lorenzgeisser/Pen-Plotter/CAD/Pulley.SLDASM

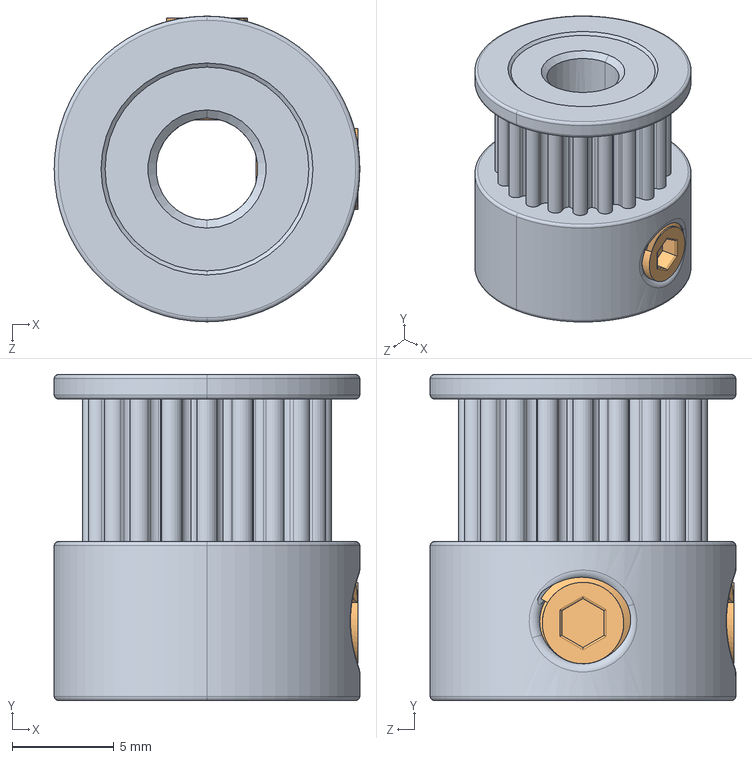
[picture p1: CAD file, 2022-06-19]
CAD/Pulley.SLDASM
15.0 x 16.0 x 15.0 mm
Pulley.STEP
Pulley Screw.STEP x 2
