lorenzgeisser/Pen-Plotter/CAD/Belt Clamp.SLDPRT

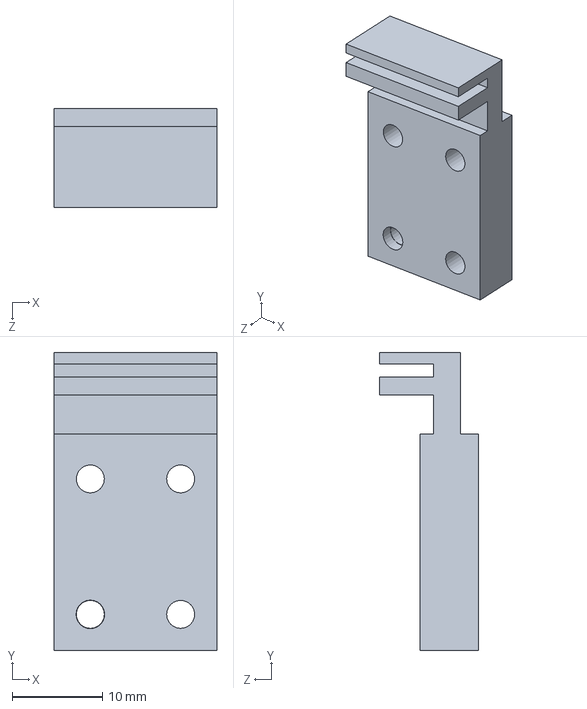
[picture p2: CAD file, 2022-06-23]
CAD/Belt Clamp.SLDPRT
18.0 x 33.0 x 11.0 mm
