lorenzgeisser/Pen-Plotter/PCB/KicadFiles/3d/OLED TFT 0.96 inch 64x128 monochrome.STEP

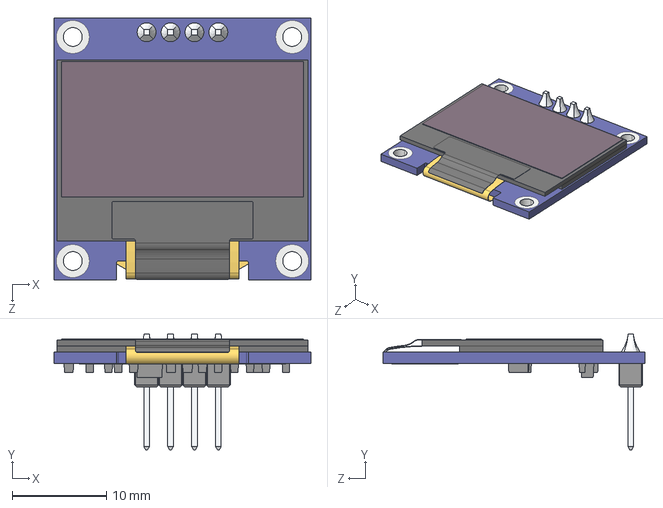
[picture p3: CAD file, 2022-07-03]
PCB/KicadFiles/3d/OLED TFT 0.96 inch 64x128 monochrome.STEP
27.3 x 12.3 x 27.8 mm
