lorenzgeisser/Pen-Plotter/CAD/Middle.SLDPRT

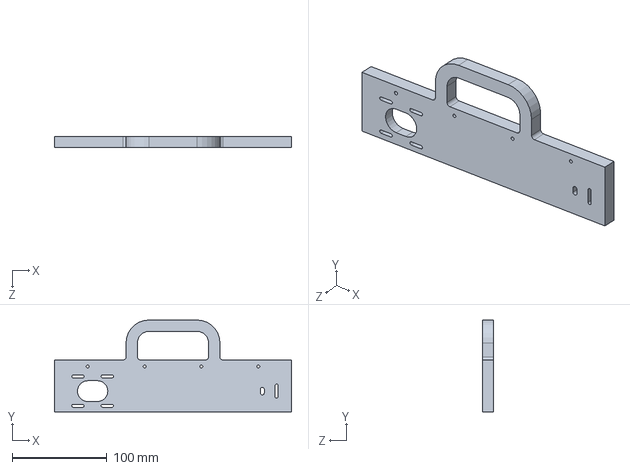
[picture p4: CAD file, 2022-06-20]
CAD/Middle.SLDPRT
250.0 x 97.0 x 12.0 mm
