lorenzgeisser/Pen-Plotter/PCB/KicadFiles/3d/BarrelJackSMD v3.step

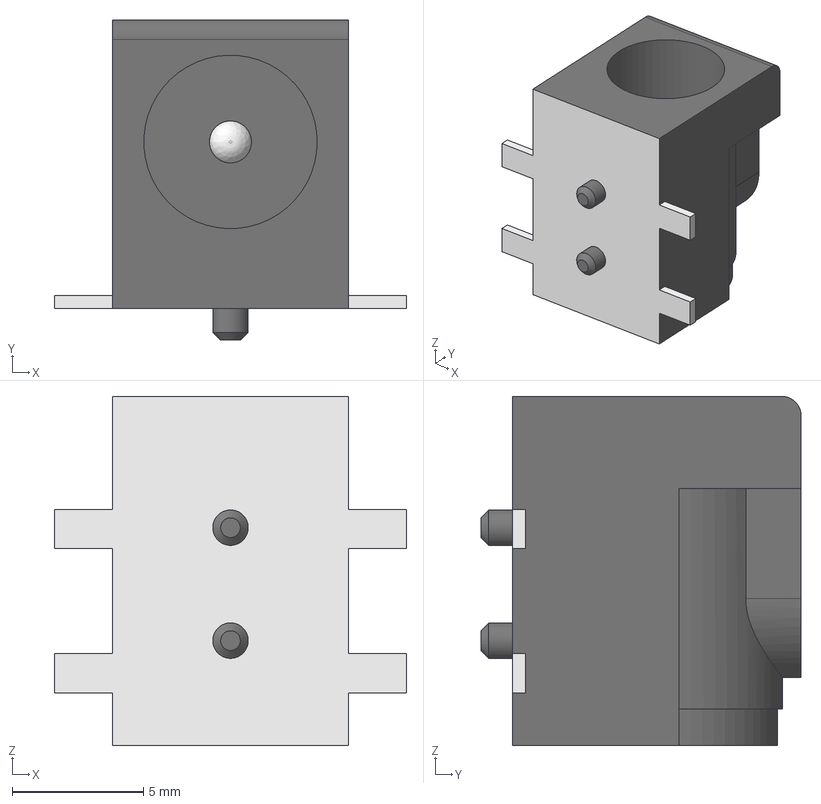
[picture p5: CAD file, 2022-07-03]
PCB/KicadFiles/3d/BarrelJackSMD v3.step
13.4 x 12.2 x 13.3 mm
