lorenzgeisser/Pen-Plotter/CAD/Leg Right.SLDPRT

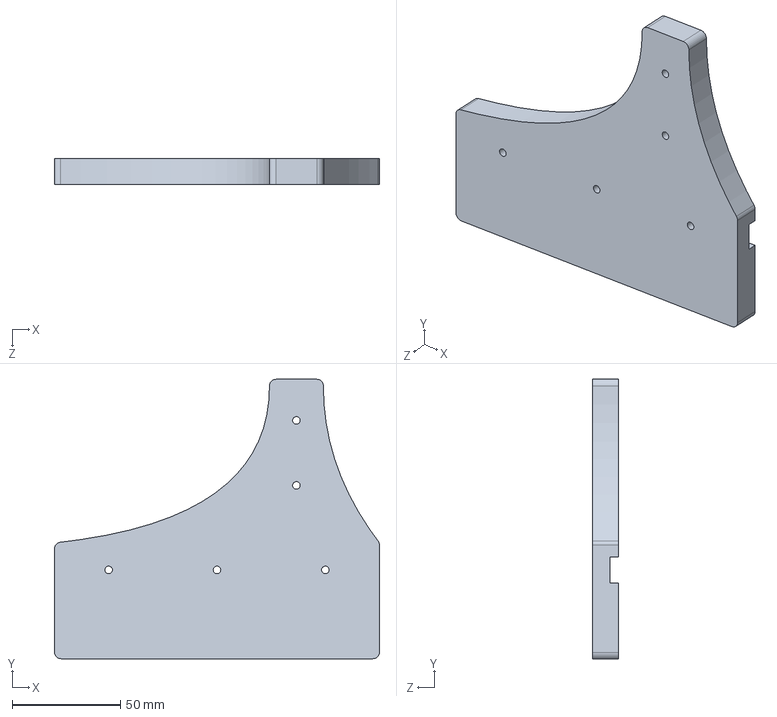
[picture p6: CAD file, 2022-06-20]
CAD/Leg Right.SLDPRT
150.0 x 129.0 x 12.0 mm
