lorenzgeisser/Pen-Plotter/PCB/KicadFiles/3d/TMC2209-V1.2 Bigtreetech.STEP

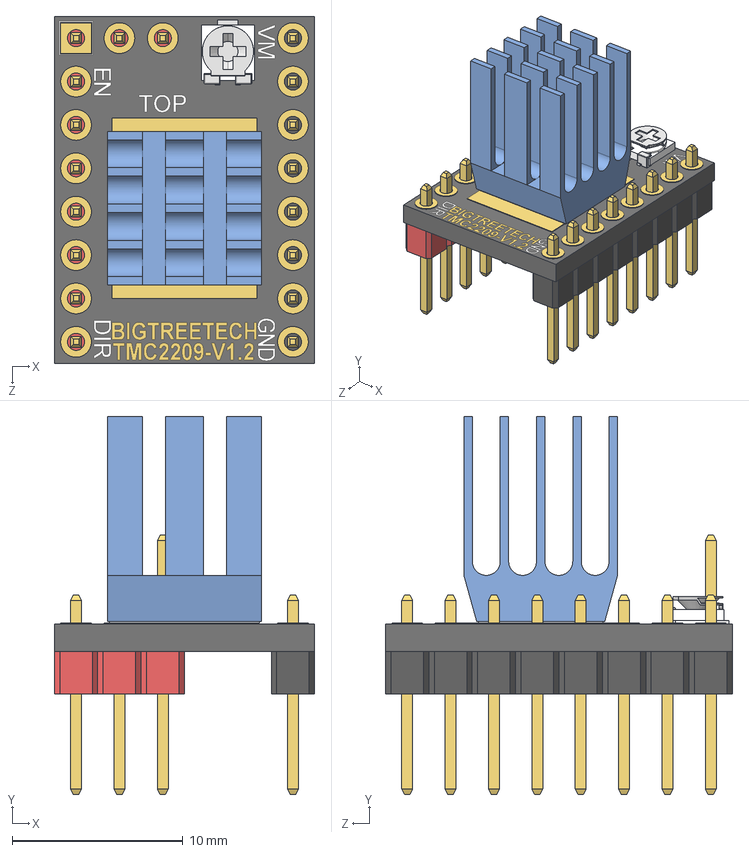
[picture p7: CAD file, 2022-06-23]
PCB/KicadFiles/3d/TMC2209-V1.2 Bigtreetech.STEP
15.2 x 22.1 x 20.3 mm
TMC2209_board
Pin_Header_1x2_red
Pin_Header_1x8_red
Pin_Header_1x8_black
EVM-3E___ _________
TMC2209_heatsink
