lorenzgeisser/Pen-Plotter/CAD/Schalter.SLDPRT

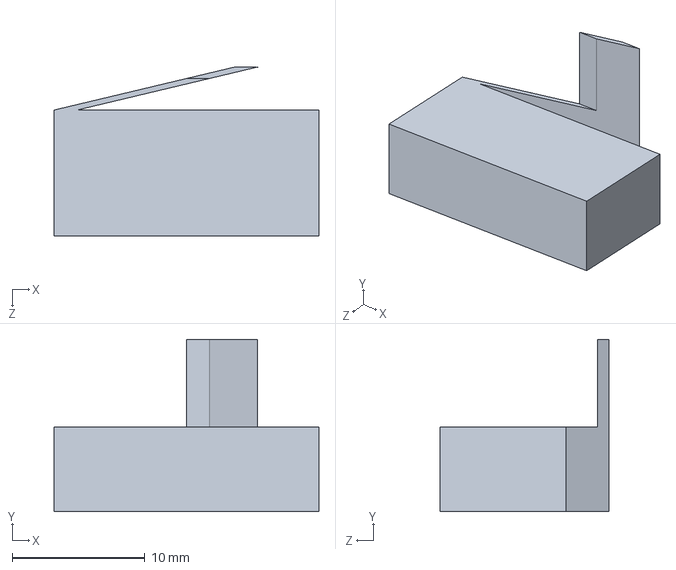
[picture p8: CAD file, 2022-06-20]
CAD/Schalter.SLDPRT
20.0 x 13.0 x 12.8 mm
