lorenzgeisser/Pen-Plotter/CAD/Penholder 1.SLDPRT

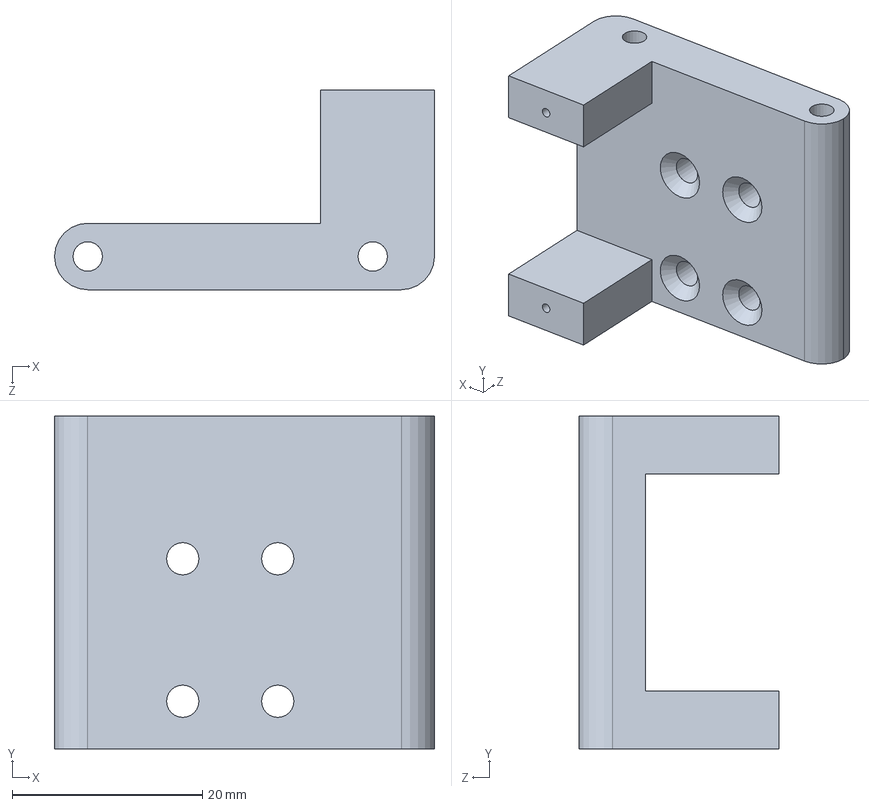
[picture p9: CAD file, 2022-06-19]
CAD/Penholder 1.SLDPRT
40.0 x 35.0 x 21.0 mm
