lorenzgeisser/Pen-Plotter/CAD/Pulley Holder.SLDPRT

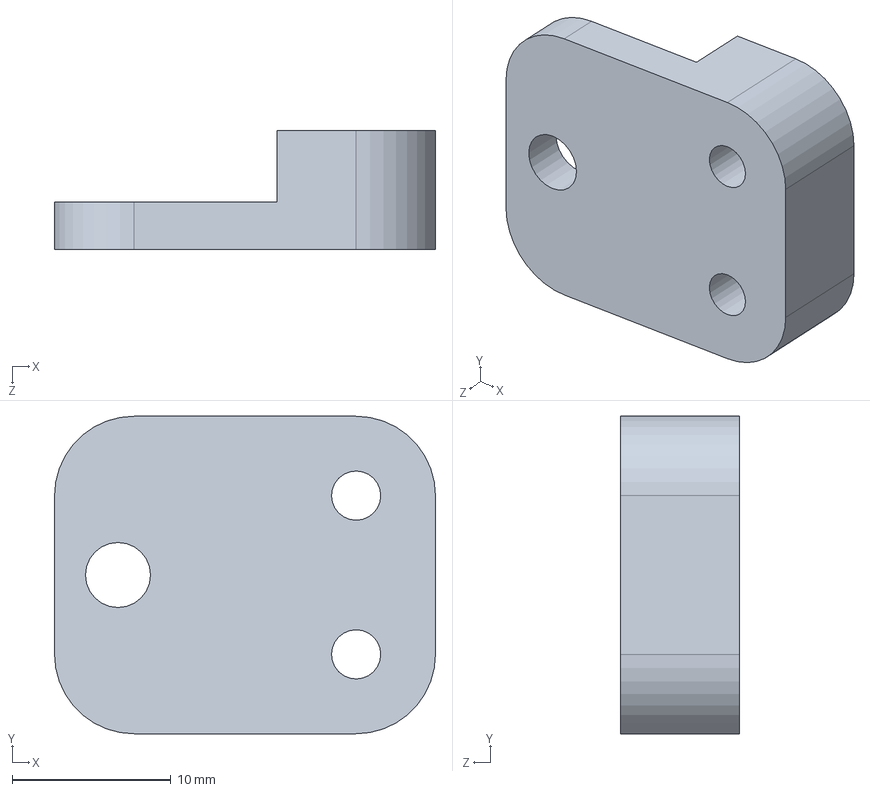
[picture p10: CAD file, 2022-06-19]
CAD/Pulley Holder.SLDPRT
24.0 x 20.0 x 7.50 mm
