lorenzgeisser/Pen-Plotter/CAD/Pin 3mm.SLDPRT

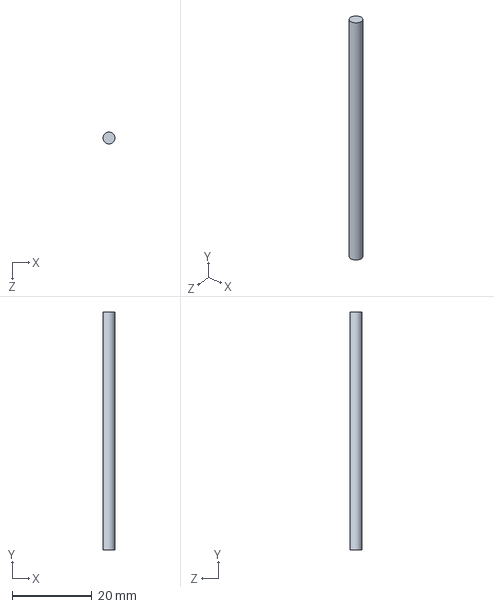
[picture p11: CAD file, 2022-06-19]
CAD/Pin 3mm.SLDPRT
3.00 x 59.7 x 3.00 mm
