lorenzgeisser/Pen-Plotter/CAD/Servo Horn.SLDPRT

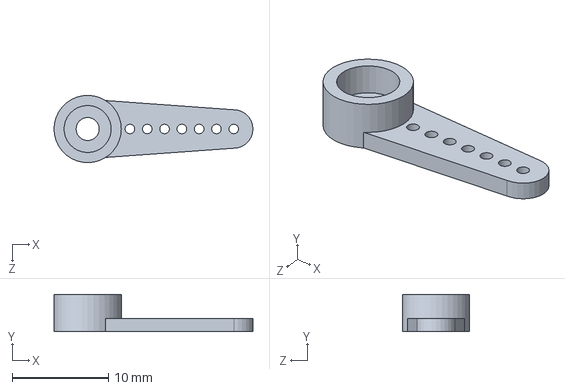
[picture p12: CAD file, 2022-06-19]
CAD/Servo Horn.SLDPRT
20.7 x 3.90 x 7.00 mm
