lorenzgeisser/Pen-Plotter/CAD/Servo.SLDPRT

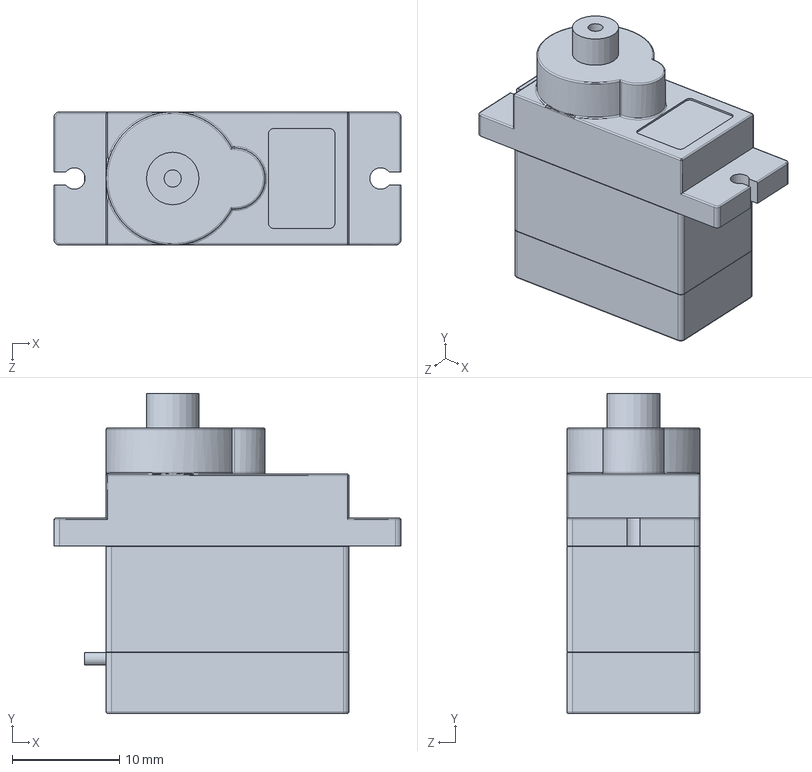
[picture p13: CAD file, 2022-06-19]
CAD/Servo.SLDPRT
32.3 x 29.8 x 12.4 mm
