lorenzgeisser/Pen-Plotter/CAD/Cart.SLDPRT

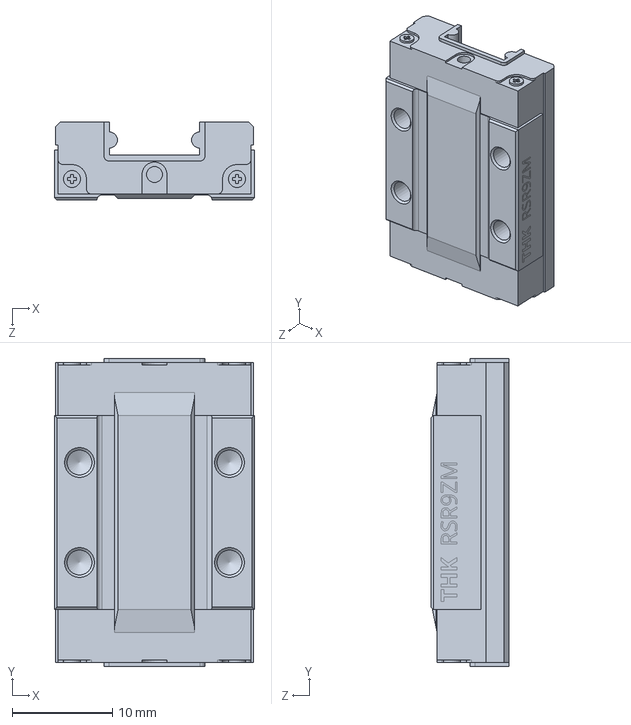
[picture p14: CAD file, 2022-06-19]
CAD/Cart.SLDPRT
20.0 x 30.8 x 7.80 mm
