lorenzgeisser/Pen-Plotter/CAD/Pen.SLDPRT

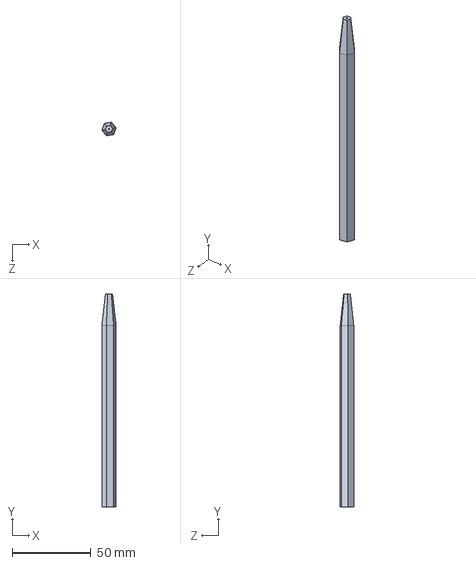
[picture p15: CAD file, 2022-06-19]
CAD/Pen.SLDPRT
9.12 x 135.0 x 8.63 mm
