lorenzgeisser/Pen-Plotter/CAD/Coaster.SLDPRT

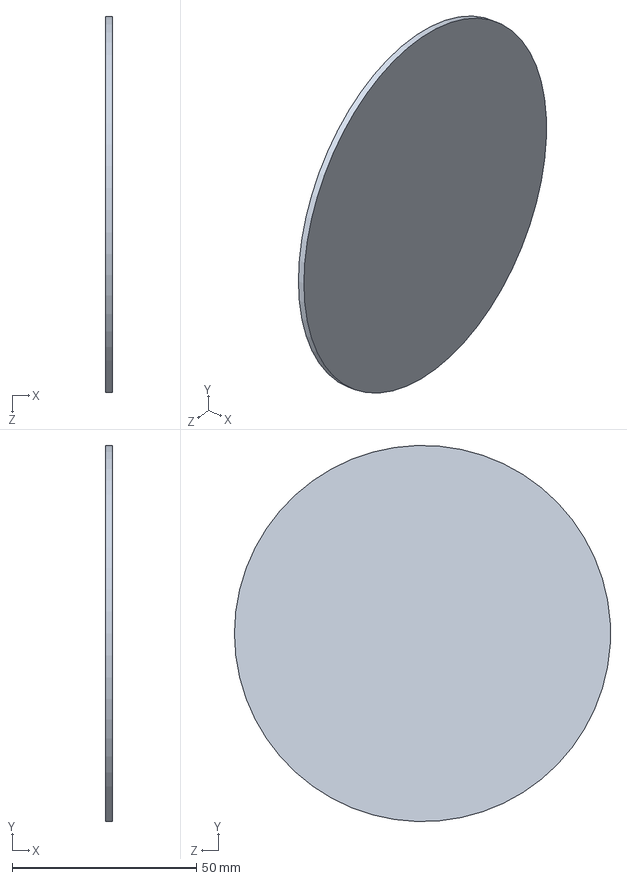
[picture p16: CAD file, 2022-06-19]
CAD/Coaster.SLDPRT
1.80 x 102.0 x 102.0 mm
