lorenzgeisser/Pen-Plotter/CAD/Baseplate.SLDPRT

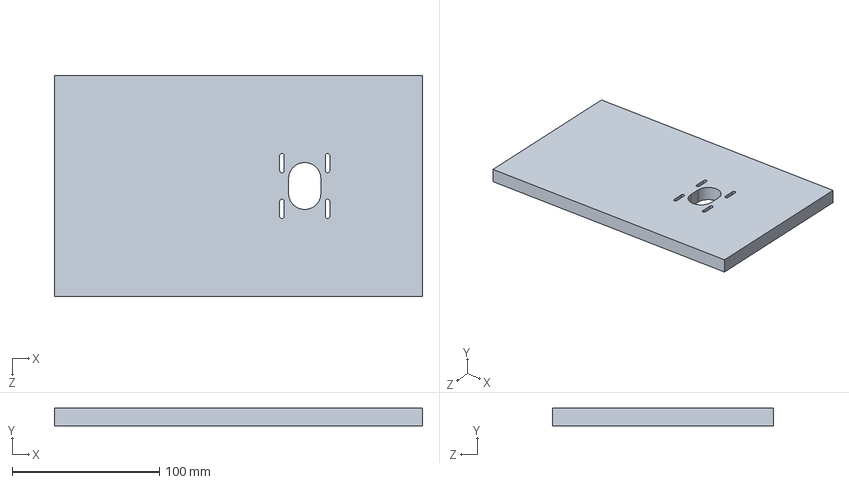
[picture p17: CAD file, 2022-06-19]
CAD/Baseplate.SLDPRT
250.0 x 12.0 x 150.0 mm
