lorenzgeisser/Pen-Plotter/CAD/Coaster Holder.SLDPRT

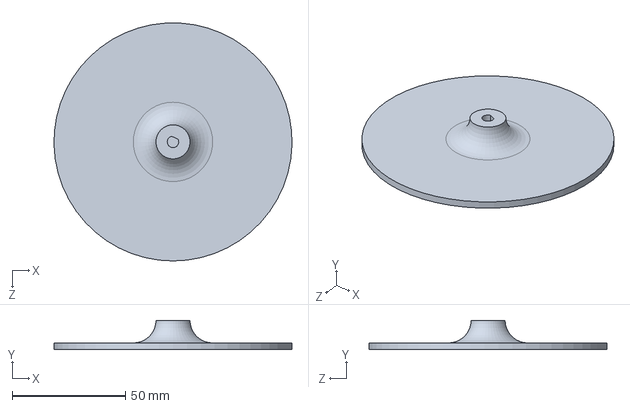
[picture p18: CAD file, 2022-06-19]
CAD/Coaster Holder.SLDPRT
105.0 x 13.0 x 104.9 mm
