lorenzgeisser/Pen-Plotter/CAD/Penholder 2.SLDPRT

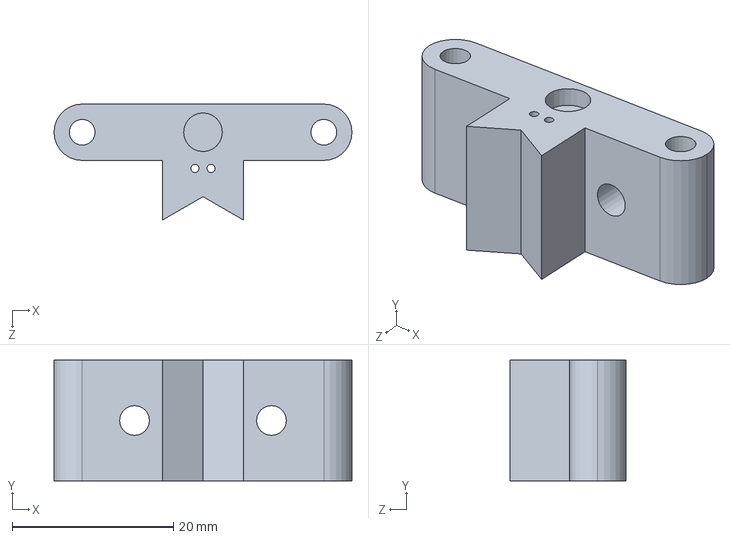
[picture p19: CAD file, 2022-06-19]
CAD/Penholder 2.SLDPRT
37.0 x 15.0 x 14.4 mm
