lorenzgeisser/Pen-Plotter/CAD/Motor.SLDPRT

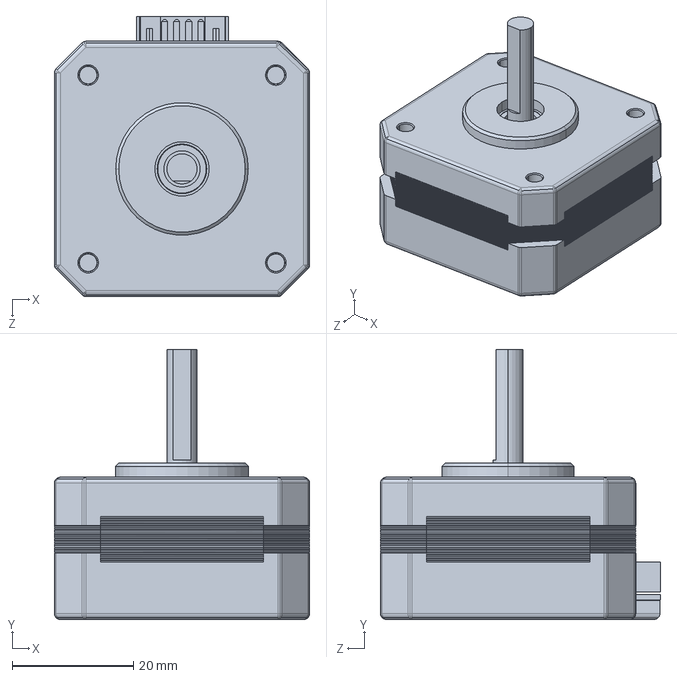
[picture p20: CAD file, 2022-06-19]
CAD/Motor.SLDPRT
42.2 x 44.6 x 46.3 mm
