lorenzgeisser/Pen-Plotter/CAD/Flat Pulley.SLDPRT

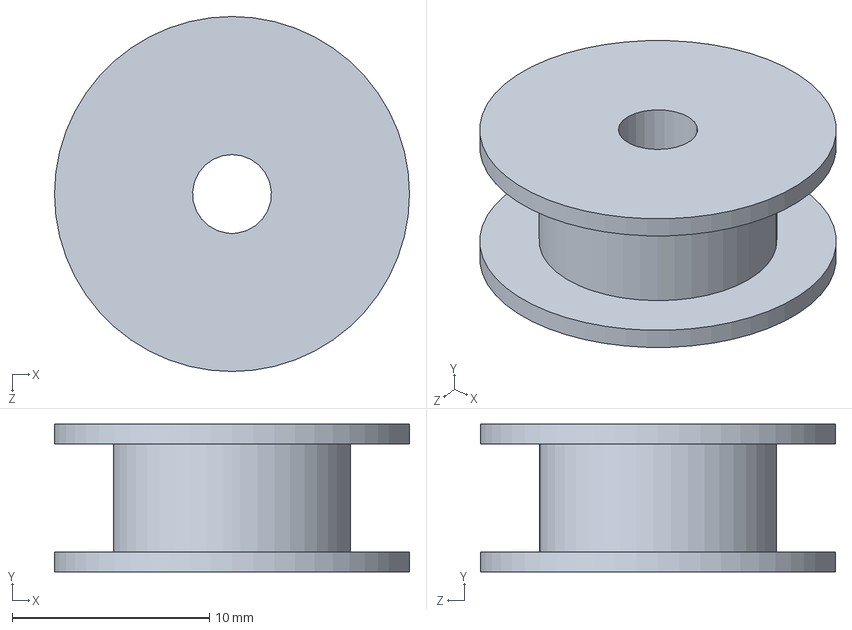
[picture p21: CAD file, 2022-06-19]
CAD/Flat Pulley.SLDPRT
18.0 x 7.50 x 18.0 mm
