lorenzgeisser/Pen-Plotter/CAD/Rail.SLDPRT

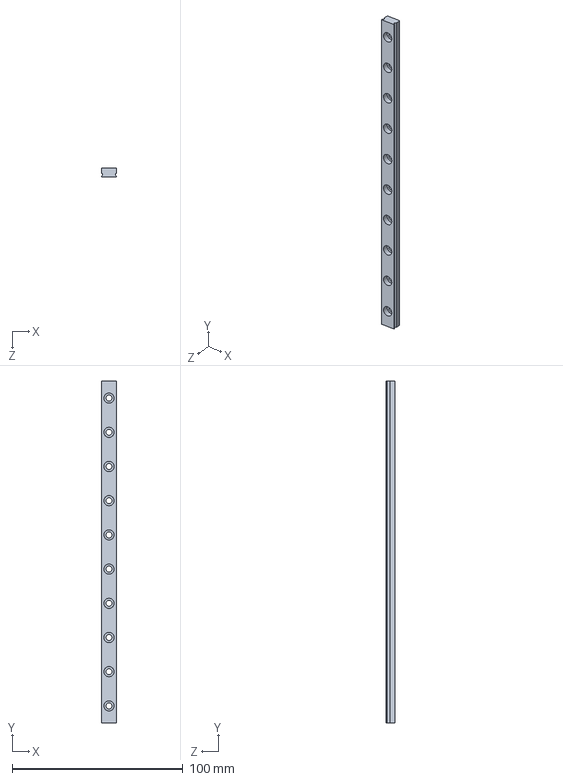
[picture p22: CAD file, 2022-06-19]
CAD/Rail.SLDPRT
9.00 x 200.0 x 5.50 mm
