lorenzgeisser/Pen-Plotter/(list of files, cad)

Other CAD files:
CAD/Leg Left.SLDPRT
CAD/Pulley.STEP.SLDPRT
CAD/Baseplate.DXF
CAD/Baseplate.SLDDRW
CAD/Leg Left.DXF
CAD/Leg Left.SLDDRW
CAD/Leg Right.DXF
CAD/Leg Right.SLDDRW
CAD/M3 Washer.SLDPRT
CAD/Middle.DXF
CAD/Middle.SLDDRW
CAD/Pulley Screw.STEP.SLDPRT
