lorenzgeisser/Pen-Plotter/PCB/KicadFiles/Plotter.kicad_pcb

## KiCad design PCB/KicadFiles/Plotter.kicad_pcb (2022-07-11)

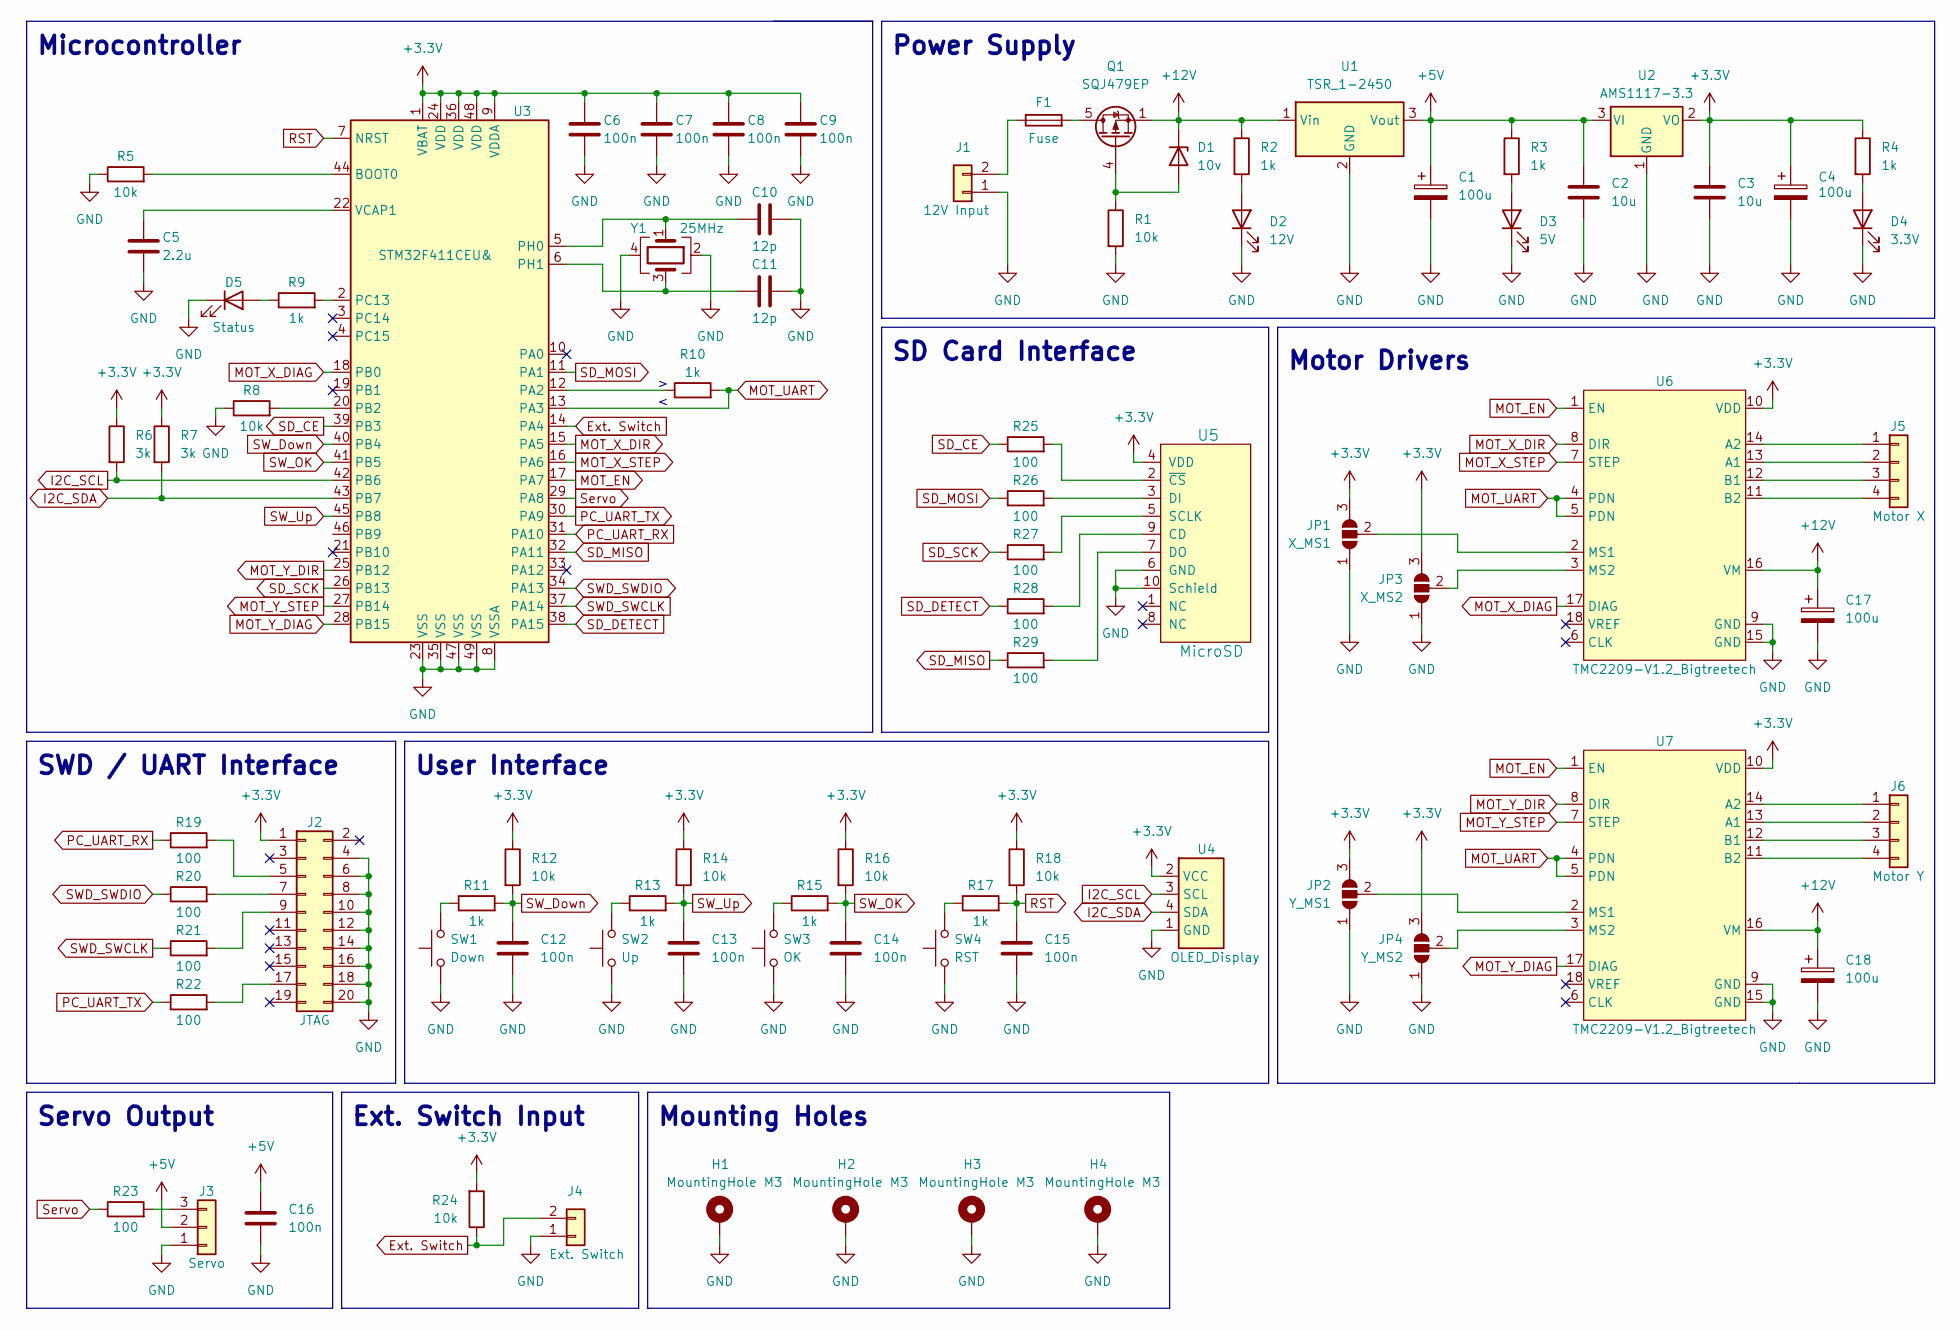
[picture p24: schematic Plotter.kicad_sch]

Parts:
C1, C4, C17, C18: 100u; CP_Elec_6.3x7.7
C2, C3: 10u; C_0805_2012Metric
C5: 2.2u; C_0402_1005Metric
C6, C7, C8, C9: 100n; C_0402_1005Metric
C10, C11: 12p; C_0402_1005Metric
C12, C13, C14, C15, C16: 100n; C_0805_2012Metric
D1: 10v; SOT-23
D2: 12V; LED_0805_2012Metric
D3: 5V; LED_0805_2012Metric
D4: 3.3V; LED_0805_2012Metric
D5: Status; LED_0805_2012Metric
F1: Fuse; Fuseholder_Cylinder-5x20mm_Schurter_0031_8201_Horizontal_Op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
H1, H2, H3, H4: MountingHole M3; MountingHole_3.2mm_M3_Pad_Via
J1: 12V Input; JST_XH_B2B-XH-A_1x02_P2.50mm_Vertical
J2: JTAG; IDC-Header_2x10_P2.54mm_Vertical
J3: Servo; JST_XH_B3B-XH-A_1x03_P2.50mm_Vertical
J4: Ext. Switch; JST_XH_B2B-XH-A_1x02_P2.50mm_Vertical
J5: Motor X; JST_XH_B4B-XH-A_1x04_P2.50mm_Vertical
J6: Motor Y; JST_XH_B4B-XH-A_1x04_P2.50mm_Vertical
JP1: X_MS1; SolderJumper-3_P1.3mm_Open_RoundedPad1.0x1.5mm
JP2: Y_MS1; SolderJumper-3_P1.3mm_Open_RoundedPad1.0x1.5mm
JP3: X_MS2; SolderJumper-3_P1.3mm_Open_RoundedPad1.0x1.5mm
JP4: Y_MS2; SolderJumper-3_P1.3mm_Open_RoundedPad1.0x1.5mm
Q1: SQJ479EP; TDSON-8-1
R1, R5, R8, R12, R14, R16, R18, R24: 10k; R_0805_2012Metric
R2, R3, R4, R9, R10, R11, R13, R15, R17: 1k; R_0805_2012Metric
R6, R7: 3k; R_0805_2012Metric
R19, R20, R21, R22, R23, R25, R26, R27, R28, R29: 100; R_0805_2012Metric
SW1: Down; SW_PUSH_6mm_H5mm
SW2: Up; SW_PUSH_6mm_H5mm
SW3: OK; SW_PUSH_6mm_H5mm
SW4: RST; SW_PUSH_6mm_H5mm
U1: TSR_1-2450; Converter_DCDC_TRACO_TSR-1_THT
U2: AMS1117-3.3; SOT-223-3_TabPin2
U3: STM32F411CEU&; QFN-48-1EP_7x7mm_P0.5mm_EP5.6x5.6mm
U4: OLED_Display; Display_128x64_096_I2C
U5: MicroSD; GCT-MEM2055-00-190-01-A
U6, U7: TMC2209-V1.2_Bigtreetech; TMC2209-V1.2 Bigtreetech
Y1: 25MHz; Crystal_SMD_3225-4Pin_3.2x2.5mm

Connections:
+3.3V: C3.1, C4.1, C6.1, C7.1, C8.1, C9.1, J2.1, JP1.3 (B), JP2.3 (B), JP3.3 (B), JP4.3 (B), R4.1, R6.1, R7.1, R12.1, R14.1, R16.1, R18.1, R24.2, U2.2 (VO), U3.1 (VBAT), U3.9 (VDDA), U3.24 (VDD), U3.36 (VDD), U3.48 (VDD), U4.2 (VCC), U5.4 (VDD), U6.10 (VDD), U7.10 (VDD)
+5V: C1.1, C2.1, C16.1, J3.2, R3.1, U1.3 (Vout), U2.3 (VI)
+12V: C17.1, C18.1, D1.3 (K), Q1.1 (S), Q1.2 (S), Q1.3 (S), R2.1, U1.1 (Vin), U6.16 (VM), U7.16 (VM)
Ext. Switch: J4.2, R24.1, U3.14 (PA4)
GND: C1.2, C2.2, C3.2, C4.2, C5.2, C6.2, C7.2, C8.2, C9.2, C10.2, C11.2, C12.2, C13.2, C14.2, C15.2, C16.2, C17.2, C18.2, D2.1 (K), D3.1 (K), D4.1 (K), D5.1 (K), H1.1, H2.1, H3.1, H4.1, J1.1, J2.4, J2.6, J2.8, J2.10, J2.12, J2.14, J2.16, J2.18, J2.20, J3.1, J4.1, JP1.1 (A), JP2.1 (A), JP3.1 (A), JP4.1 (A), R1.2, R5.1, R8.1, SW1.1, SW2.1, SW3.1, SW4.1, U1.2 (GND), U2.1 (GND), U3.8 (VSSA), U3.23 (VSS), U3.35 (VSS), U3.47 (VSS), U3.49 (VSS), U4.1 (GND), U5.6 (GND), U5.10 (Schield), U6.9 (GND), U6.15 (GND), U7.9 (GND), U7.15 (GND), Y1.2, Y1.4
I2C_SCL: R6.2, U3.42 (PB6), U4.3 (SCL)
I2C_SDA: R7.2, U3.43 (PB7), U4.4 (SDA)
MOT_EN: U3.17 (PA7), U6.1 (EN), U7.1 (EN)
MOT_UART: R10.2, U3.13 (PA3), U6.4 (PDN), U6.5 (PDN), U7.4 (PDN), U7.5 (PDN)
MOT_X_DIAG: U3.18 (PB0), U6.17 (DIAG)
MOT_X_DIR: U3.15 (PA5), U6.8 (DIR)
MOT_X_STEP: U3.16 (PA6), U6.7 (STEP)
MOT_Y_DIAG: U3.28 (PB15), U7.17 (DIAG)
MOT_Y_DIR: U3.25 (PB12), U7.8 (DIR)
MOT_Y_STEP: U3.27 (PB14), U7.7 (STEP)
unnamed: C5.1, U3.22 (VCAP1)
unnamed: C10.1, U3.5 (PH0), Y1.1
unnamed: C11.1, U3.6 (PH1), Y1.3
unnamed: D1.1 (A), Q1.4 (G), R1.1
unnamed: D2.2 (A), R2.2
unnamed: D3.2 (A), R3.2
unnamed: D4.2 (A), R4.2
unnamed: D5.2 (A), R9.1
unnamed: F1.1, J1.2
unnamed: F1.2, Q1.5 (D)
unnamed: J2.5, R19.2
unnamed: J2.7, R20.2
unnamed: J2.9, R21.2
unnamed: J2.17, R22.2
unnamed: J3.3, R23.2
unnamed: J5.1, U6.14 (A2)
unnamed: J5.2, U6.13 (A1)
unnamed: J5.3, U6.12 (B1)
unnamed: J5.4, U6.11 (B2)
unnamed: J6.1, U7.14 (A2)
unnamed: J6.2, U7.13 (A1)
unnamed: J6.3, U7.12 (B1)
unnamed: J6.4, U7.11 (B2)
unnamed: JP1.2 (C), U6.2 (MS1)
unnamed: JP2.2 (C), U7.2 (MS1)
unnamed: JP3.2 (C), U6.3 (MS2)
unnamed: JP4.2 (C), U7.3 (MS2)
unnamed: R5.2, U3.44 (BOOT0)
unnamed: R8.2, U3.20 (PB2)
unnamed: R9.2, U3.2 (PC13)
unnamed: R10.1, U3.12 (PA2)
unnamed: R11.1, SW1.2
unnamed: R13.1, SW2.2
unnamed: R15.1, SW3.2
unnamed: R17.1, SW4.2
unnamed: R25.2, U5.2 (~CS)
unnamed: R26.2, U5.3 (DI)
unnamed: R27.2, U5.5 (SCLK)
unnamed: R28.2, U5.9 (CD)
unnamed: R29.2, U5.7 (DO)
PC_UART_RX: R19.1, U3.31 (PA10)
PC_UART_TX: R22.1, U3.30 (PA9)
RST: C15.1, R17.2, R18.2, U3.7 (NRST)
SD_CE: R25.1, U3.39 (PB3)
SD_DETECT: R28.1, U3.38 (PA15)
SD_MISO: R29.1, U3.32 (PA11)
SD_MOSI: R26.1, U3.11 (PA1)
SD_SCK: R27.1, U3.26 (PB13)
SWD_SWCLK: R21.1, U3.37 (PA14)
SWD_SWDIO: R20.1, U3.34 (PA13)
SW_Down: C12.1, R11.2, R12.2, U3.40 (PB4)
SW_OK: C14.1, R15.2, R16.2, U3.41 (PB5)
SW_Up: C13.1, R13.2, R14.2, U3.45 (PB8)
Servo: R23.1, U3.29 (PA8)

Notes on the sheet:
Servo Output
Ext. Switch Input
Motor Drivers
User Interface
Mounting Holes
Microcontroller
SWD / UART Interface
SD Card Interface
Power Supply

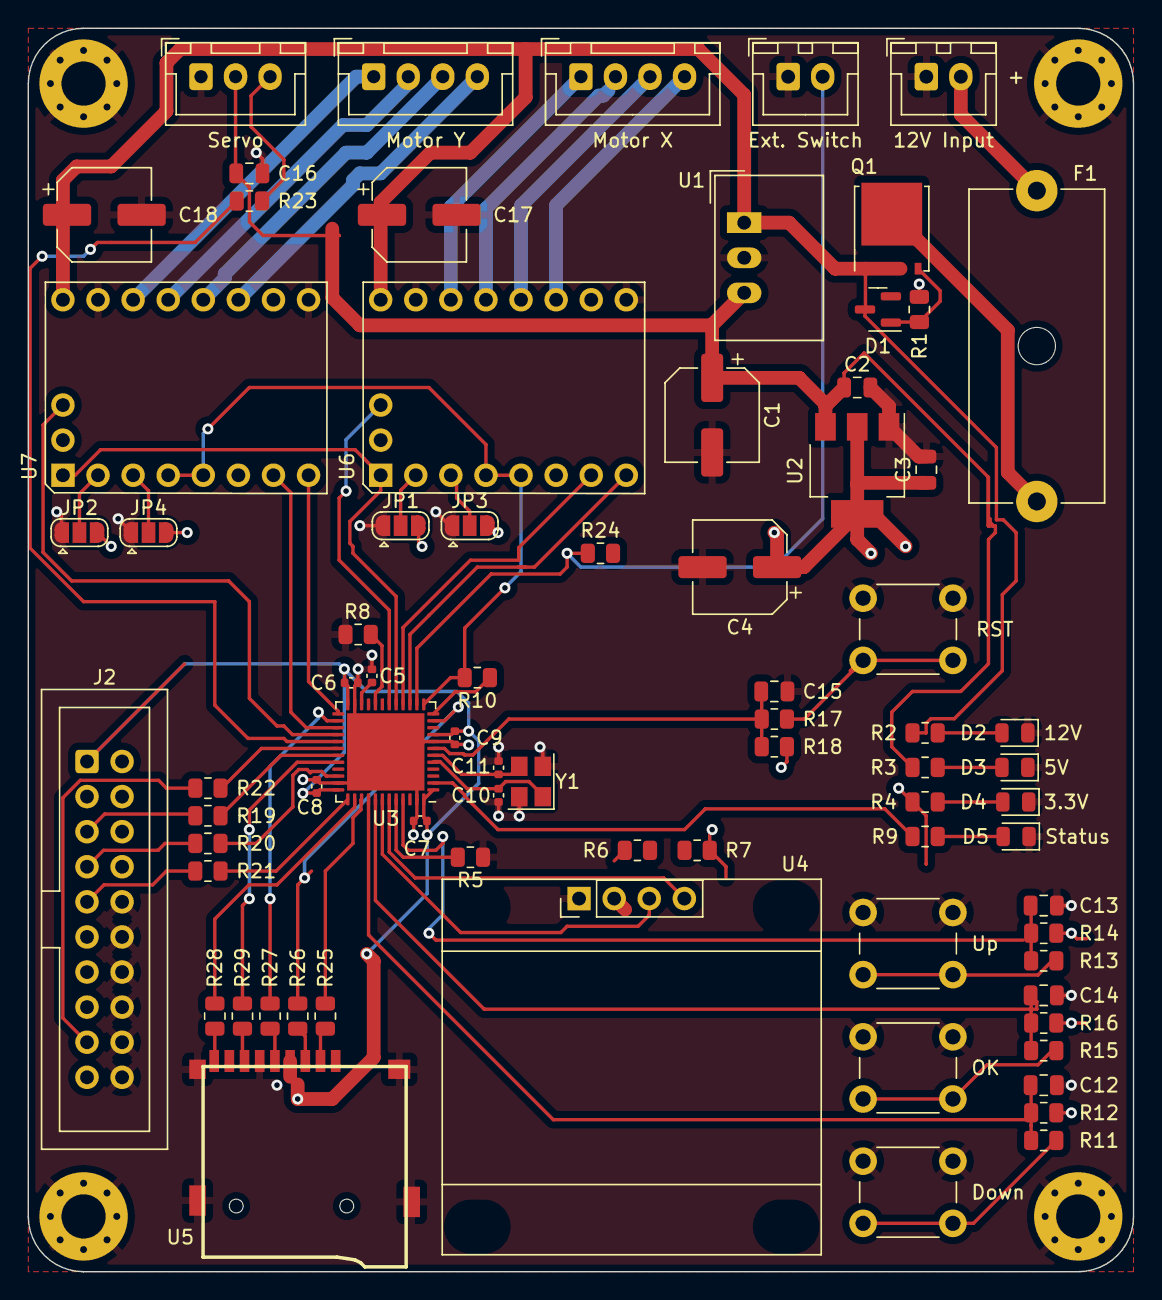
[picture p25: board Plotter.kicad_pcb from above]

Board: 4 copper layers, 80.0 x 90.0 mm, 80 parts (0 on the bottom side), 69 nets.
