lorenzgeisser/Pen-Plotter/(commit log)

2022-06-20 ready to mill
    [Leg Left.SLDPRT, Leg Right.SLDPRT, Schalter.SLDPRT]
2022-06-21 fix middle
    [Middle.DXF, Middle.SLDDRW]
2022-06-23 Revert "fix middle"
    This reverts commit 356c8d0eeff1c686e1f9719ac6f8e526ae723223.
    [Middle.DXF, Middle.SLDDRW]
2022-06-23 TMC2209 in Kicad
    [Plotter.kicad_pcb, Plotter.kicad_sch, TMC2209-V1.2 Bigtreetech.STEP]
2022-06-23 use gitignore
    [Plotter.kicad_pcb, Plotter.kicad_sch, TMC2209-V1.2 Bigtreetech.STEP]
2022-06-23 Fix Distanceon Belt Clamp
    [Belt Clamp.SLDPRT]
2022-06-28 testing sensorless homing
2022-07-01 stall detect lauft
    https://github.com/teemuatlut/TMCStepper/issues/178
    [Plotter.kicad_pcb, Plotter.kicad_sch]
2022-07-02 schematic half way done
    [Plotter.kicad_pcb, Plotter.kicad_sch]
2022-07-03 finished schematic
    [BarrelJackSMD v3.step, OLED TFT 0.96 inch 64x128 monochrome.STEP, Plotter.kicad_pcb, Plotter.kicad_sch]
2022-07-11 bald fertig
    [Plotter.kicad_pcb, Plotter.kicad_sch]
